mstellbrink/klimamessgeraet/(commit log)

2025-06-16 init: initial upload of prepared sensor samples + esp32 code
2025-06-26 disable default rtc reset and small oled-display fix
    [klimamessgeraet.ino]
2025-07-17 small CSV-Format and display fix, added 6 instead of 2 decimals to GPS-values for precision
    [klimamessgeraet.ino]
2025-07-18 Hotfix for WiFi, UV-Sensor and file download
2025-07-18 update hardware setup guide with step-up-module for general power supply
2025-07-19 revert changes from debugging UV issues
    [klimamessgeraet.ino]
